M0lion/babycall/pcb/babycall-pcb.kicad_pcb

## KiCad design pcb/babycall-pcb.kicad_pcb (2026-03-30)

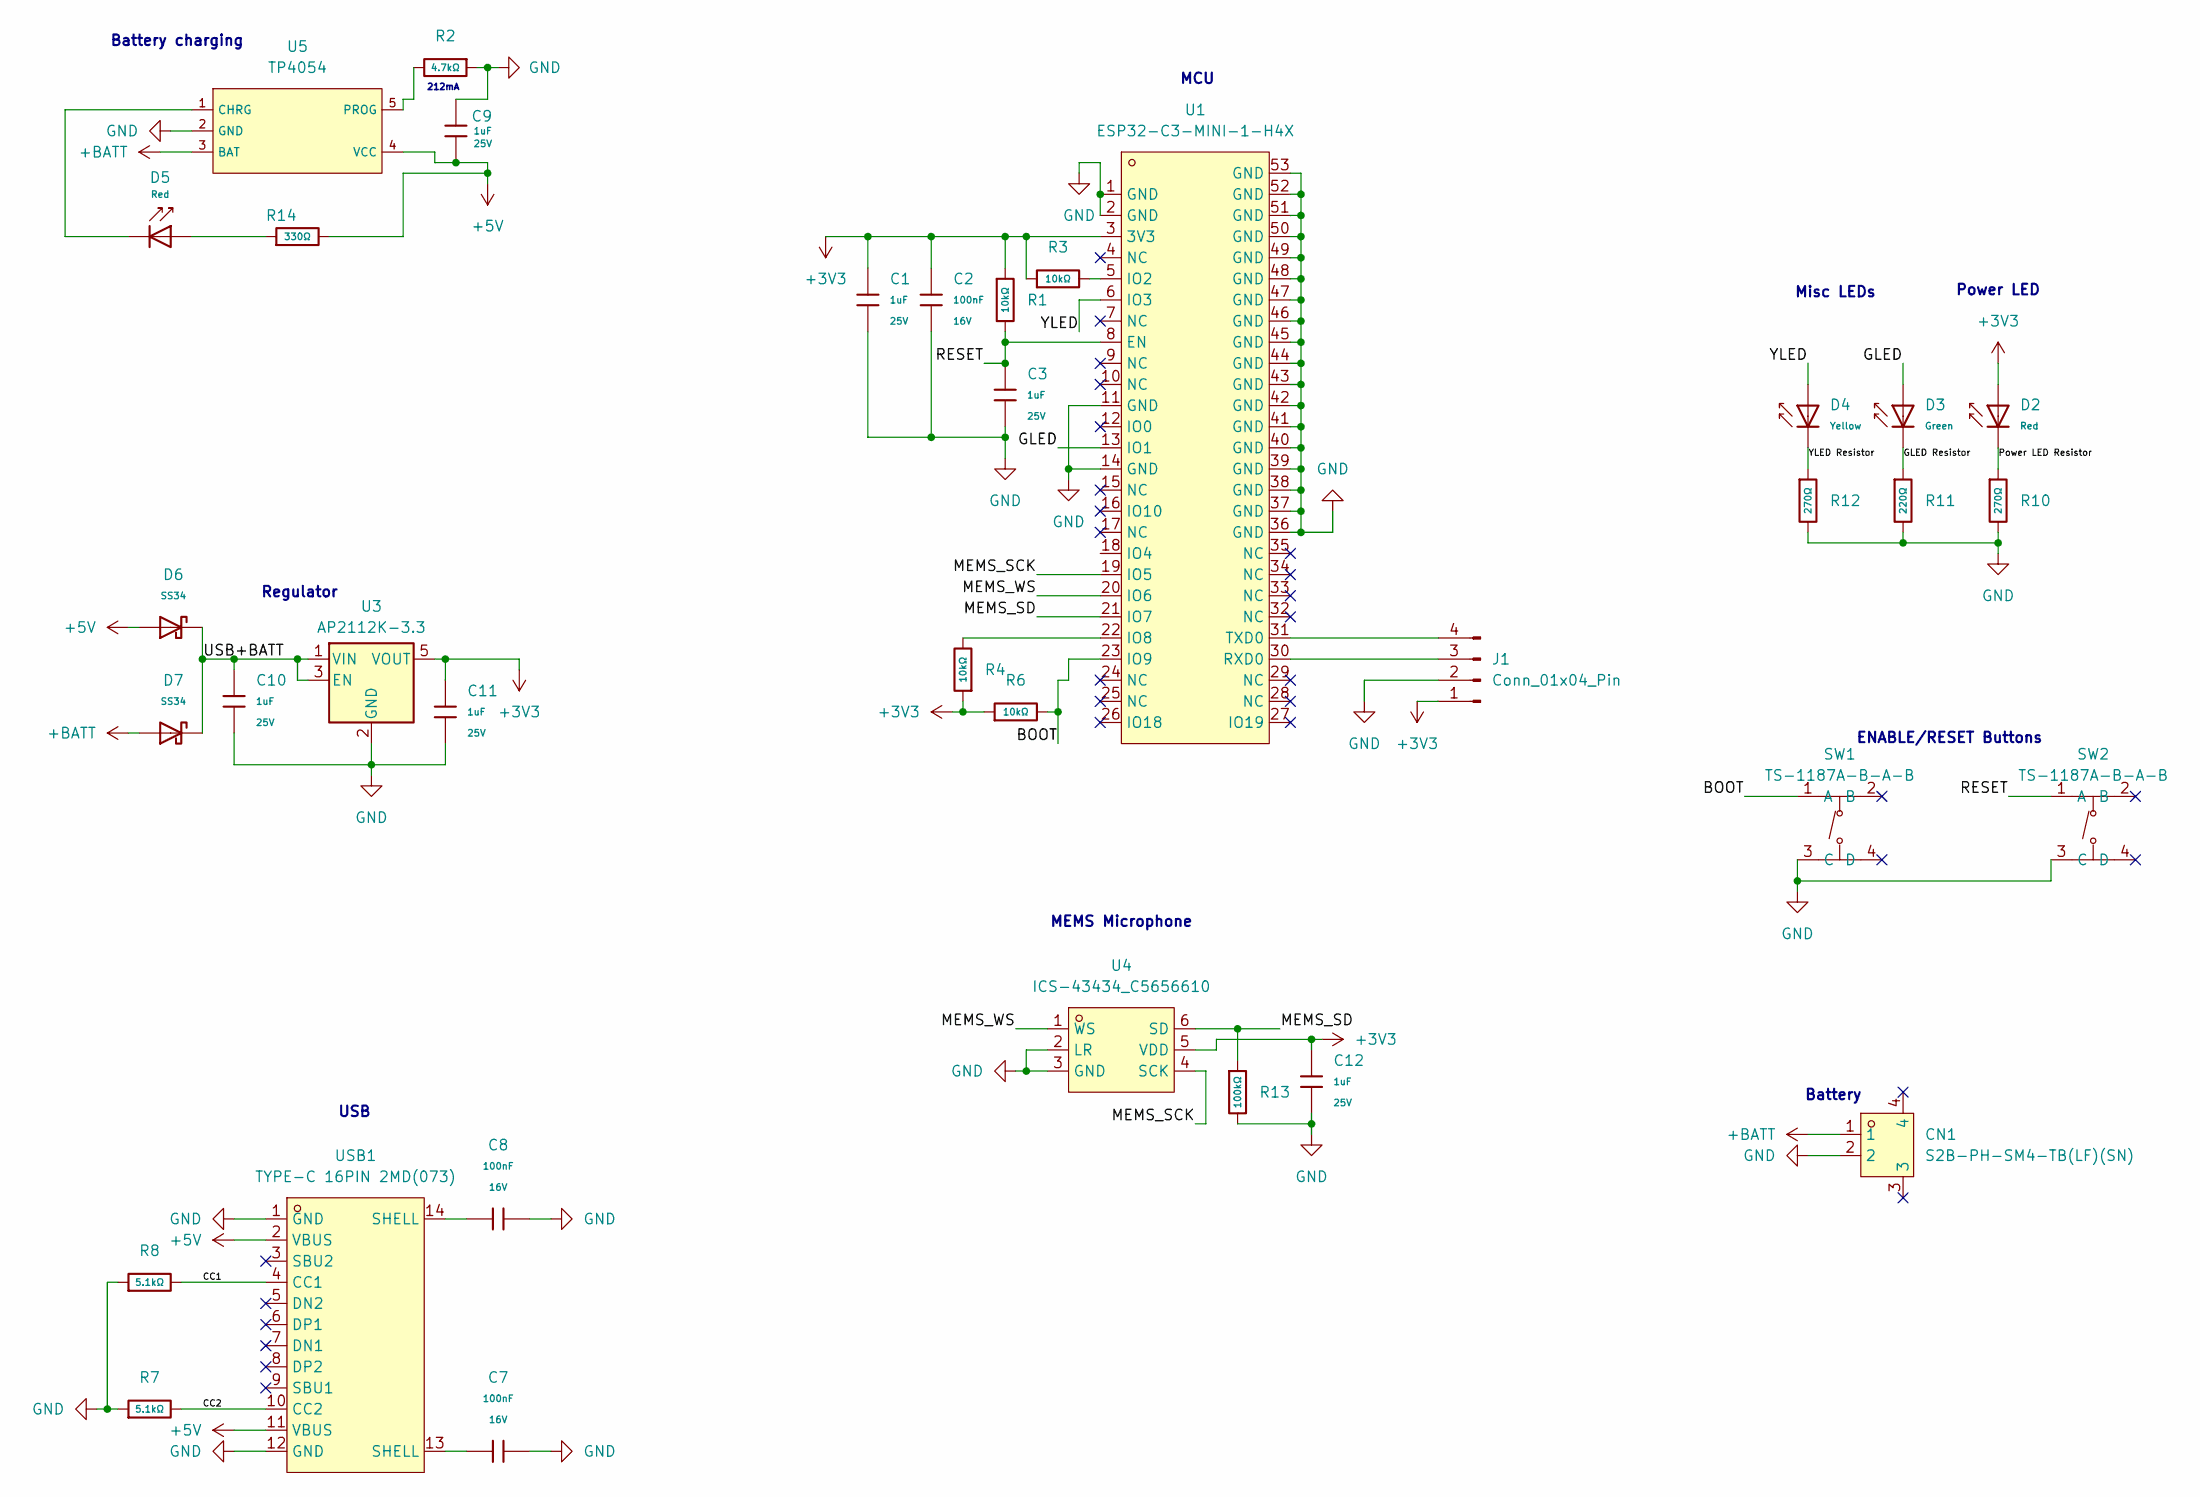
[picture p1: schematic babycall-pcb.kicad_sch]

Parts:
C1, C3, C9, C10, C11, C12: 1uF; C_0402; Voltage Rated 25V; Tolerance ±10%; Part CL05A105KA5NQNC; LCSC Part Number C52923
C2, C7, C8: 100nF; C_0402; Voltage Rated 16V; Tolerance ±10%; Part CL05B104KO5NNNC; LCSC Part Number C1525
CN1: S2B-PH-SM4-TB(LF)(SN); CONN-SMD_P2.00_S2B-PH-SM4-TB-LF-SN; LCSC Part Number C295747
D2, D5: Red; D_0603; Part KT-0603R; LCSC Part Number C2286
D3: Green; D_0805; Part KT-0805G; LCSC Part Number C2297
D4: Yellow; D_0603; Forward Voltage (VF) 1.6V~2.6V; Part NCD0603Y2; LCSC Part Number C89811
D6, D7: SS34; D_SMA; Forward Voltage (Vf@If) 0.55V@3.0A; Reverse Voltage (Vr) 40V; Part SS34; LCSC Part Number C7420365
J1: Conn_01x04_Pin; PinHeader_1x04_P2.54mm_Vertical
R1, R3, R4, R6: 10kΩ; R_0402; Overload Voltage (Max) 50V; Tolerance ±1%; Part 0402WGF1002TCE; LCSC Part Number C25744
R2: 4.7kΩ; R_0402; Overload Voltage (Max) 50V; Tolerance ±1%; Part 0402WGF4701TCE; LCSC Part Number C25900
R7, R8: 5.1kΩ; R_0402; Overload Voltage (Max) 50V; Tolerance ±1%; Part 0402WGF5101TCE; LCSC Part Number C25905
R10, R12: 270Ω; R_0603; Overload Voltage (Max) 75V; Tolerance ±1%; Part 0603WAF2700T5E; LCSC Part Number C22966
R11: 220Ω; R_0402; Overload Voltage (Max) 50V; Tolerance ±1%; Part 0402WGF2200TCE; LCSC Part Number C25091
R13: 100kΩ; R_0402; Overload Voltage (Max) 50V; Tolerance ±1%; Part 0402WGF1003TCE; LCSC Part Number C25741
R14: 330Ω; R_0402; Overload Voltage (Max) 50V; Tolerance ±1%; Part 0402WGF3300TCE; LCSC Part Number C25104
SW1, SW2: TS-1187A-B-A-B; SW-SMD_4P-L5.1-W5.1-P3.70-LS6.5-TL_H1.5; LCSC Part Number C318884
U1: ESP32-C3-MINI-1-H4X; WIFIM-SMD_ESP32-C3-MINI-1; LCSC Part Number C41349510
U3: AP2112K-3.3; SOT-23-5; LCSC Part Number C23380830
U4: ICS-43434_C5656610; MIC-SMD_6P-L3.5-W2.7-P0.90-BL; LCSC Part Number C5656610
U5: TP4054; SOT-23-5_L3.0-W1.7-P0.95-LS2.8-BL; Part TP4054-42-SOT25R; LCSC Part Number C32574
USB1: TYPE-C 16PIN 2MD(073); USB-C-SMD_TYPE-C-6PIN-2MD-073; LCSC Part Number C2765186

Connections:
+3V3: C1.1, C2.1, C11.1, C12.1, D2.2, J1.1, R1.1, R3.1, R4.1, R6.1, U1.3 (3V3), U3.5 (VOUT), U4.5 (VDD)
+5V: C9.2, D6.2, R14.2, U5.4 (VCC), USB1.2 (VBUS), USB1.11 (VBUS)
+BATT: CN1.1, D7.2, U5.3 (BAT)
/BOOT: R6.2, SW1.1 (A), U1.23 (IO9)
/CC1: R8.2, USB1.4 (CC1)
/CC2: R7.2, USB1.10 (CC2)
/GLED: D3.2, U1.13 (IO1)
/GLED Resistor: D3.1, R11.1
/MEMS_SCK: U1.19 (IO5), U4.4 (SCK)
/MEMS_SD: R13.1, U1.21 (IO7), U4.6 (SD)
/MEMS_WS: U1.20 (IO6), U4.1 (WS)
/Power LED Resistor: D2.1, R10.1
/RESET: C3.1, R1.2, SW2.1 (A), U1.8 (EN)
/USB+BATT: C10.2, D6.1, D7.1, U3.1 (VIN), U3.3 (EN)
/YLED: D4.2, U1.6 (IO3)
/YLED Resistor: D4.1, R12.1
GND: C1.2, C2.2, C3.2, C7.2, C8.2, C9.1, C10.1, C11.2, C12.2, CN1.2, J1.2, R2.1, R7.1, R8.1, R10.2, R11.2, R12.2, R13.2, SW1.3 (C), SW2.3 (C), U1.1 (GND), U1.2 (GND), U1.11 (GND), U1.14 (GND), U1.36 (GND), U1.37 (GND), U1.38 (GND), U1.39 (GND), U1.40 (GND), U1.41 (GND), U1.42 (GND), U1.43 (GND), U1.44 (GND), U1.45 (GND), U1.46 (GND), U1.47 (GND), U1.48 (GND), U1.49 (GND), U1.50 (GND), U1.51 (GND), U1.52 (GND), U1.53 (GND), U3.2 (GND), U4.2 (LR), U4.3 (GND), U5.2 (GND), USB1.1 (GND), USB1.12 (GND)
unnamed: C7.1, USB1.13 (SHELL)
unnamed: C8.1, USB1.14 (SHELL)
unnamed: D5.2, R14.1
unnamed: J1.3, U1.30 (RXD0)
unnamed: J1.4, U1.31 (TXD0)
unnamed: R3.2, U1.5 (IO2)
unnamed: R4.2, U1.22 (IO8)
unnamed: D5.1, U5.1 (CHRG)
unnamed: R2.2, U5.5 (PROG)

Notes on the sheet:
212mA
Misc LEDs
USB
Battery
MCU
ENABLE/RESET Buttons
Regulator
MEMS Microphone
Battery charging
Power LED

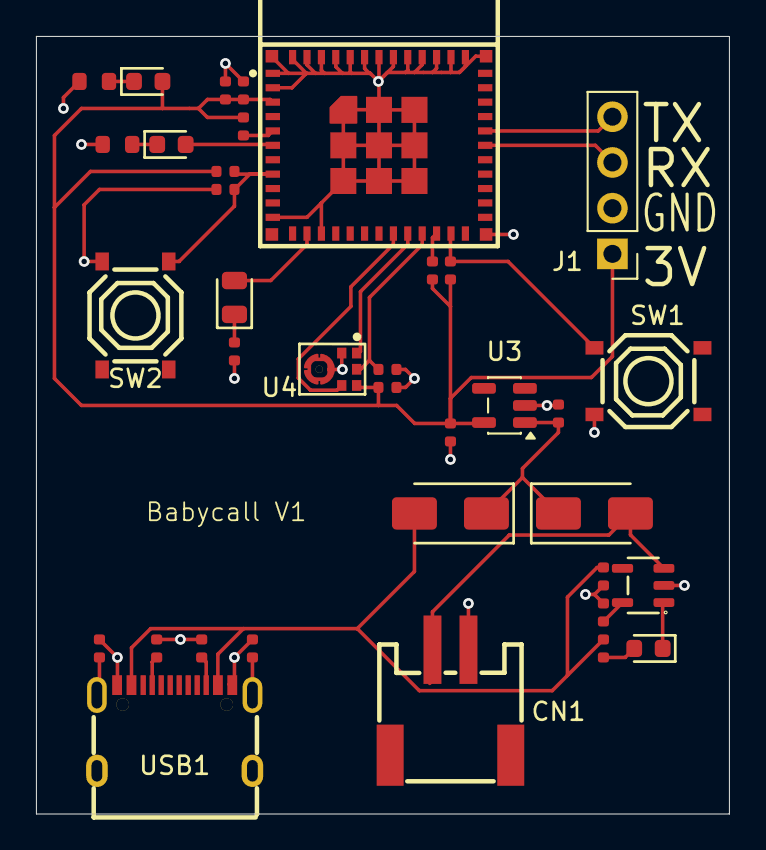
[picture p2: board babycall-pcb.kicad_pcb from above]

Board: 2 copper layers, 38.5 x 43.2 mm, 36 parts (0 on the bottom side), 26 nets.
