M0lion/babycall/(commit log)

2026-01-07 Initial commit: BLE-based baby monitor system
    Implemented a complete baby monitor system with ESP32-C3 and React Native:
    ESP32 Firmware (esp/):
    - I2S audio capture from INMP441 microphone (16kHz, 16-bit mono)
    - BLE GATT server with custom service (UUID 0x1900)
    - Audio streaming with packet fragmentation for BLE MTU
    - Configuration and control characteristics for future features
    - FreeRTOS task-based architecture with statistics tracking
    React Native App (app/):
    - BLE device scanning and connection management
    - Audio protocol parsing and frame reassembly
    - PCM audio playback with react-native-audio-api
    - Real-time monitoring UI with audio visualization
    - Statistics display and device inform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
2026-01-12 Schematic almost done
    [babycall-pcb.kicad_sch]
2026-01-12 Added usb cc resistors
    [babycall-pcb.kicad_sch]
2026-01-12 Working on schematic
2026-03-30 Claude stuff, and gitignore
    Also some models for pcb
    [babycall-pcb.kicad_pcb, babycall-pcb.kicad_sch]
